AgitPOV/Pinky/circuit/pinky 2.2 (v-usb)/usnoobie_sch_pic-20110115.png

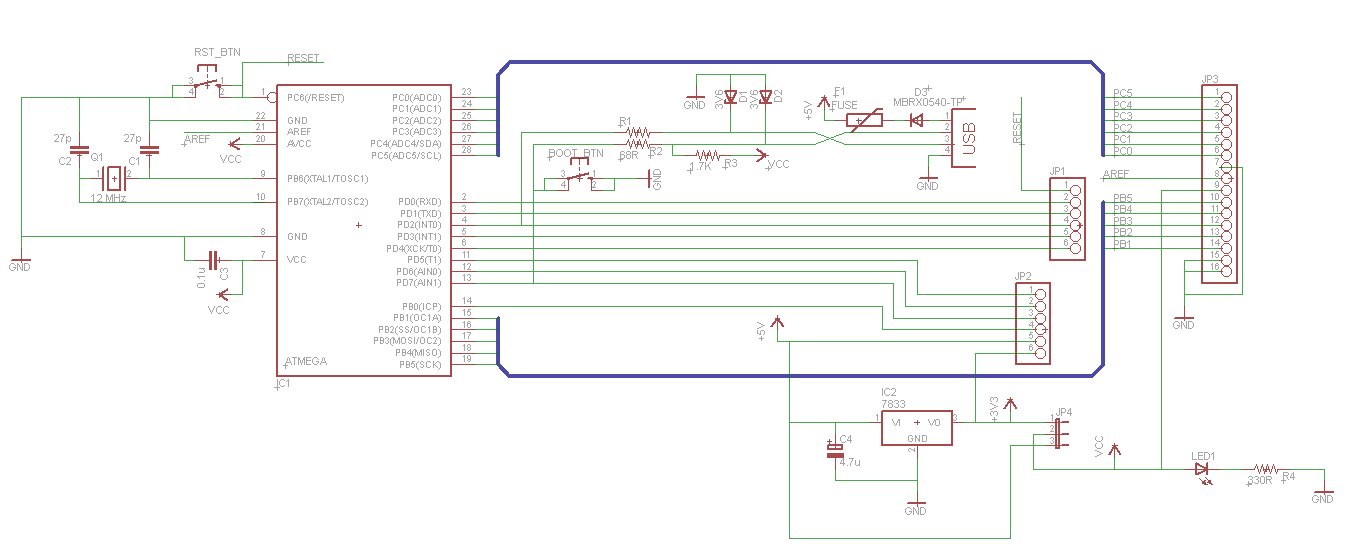
circuit/pinky 2.2 (v-usb)/usnoobie_sch_pic-20110115.png
