AgitPOV/Pinky/circuit/pinky 2.1/pinky 2.1.brd

## EAGLE design circuit/pinky 2.1/pinky 2.1.brd (2013-12-24)

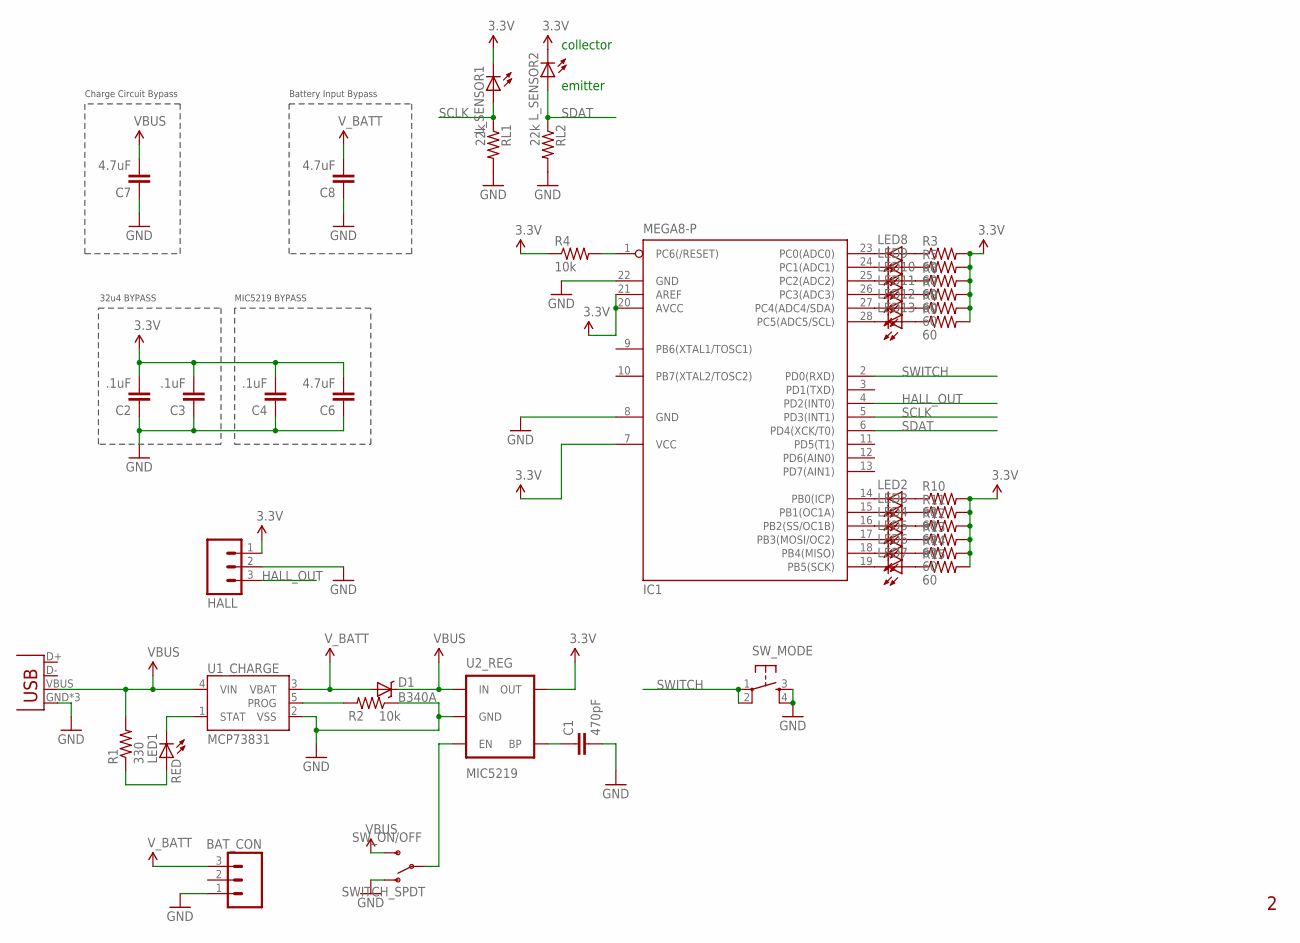
[picture p2: schematic pinky 2.1.sch]

Parts:
BAT_CON: M03PTH; 1X03
C1: 470pF; 1206
C2, C3, C4: .1uF; 1206
C6, C7, C8: 4.7uF; 1206
D1: B340A; SMA-DIODE
HALL: M03PTH; 1X03
IC1: MEGA8-P; DIL28-3
LED1: RED; LED-1206
LED2, LED3, LED4, LED5, LED6, LED7, LED8, LED9, LED10, LED11, LED12, LED13: LED1206; LED-1206
L_SENSOR1, L_SENSOR2: LED3MM
R1: 330; 1206
R2, R4: 10k; 1206
R3, R5, R6, R7, R8, R9, R10, R11, R12, R13, R14, R15: 60; 1206
RL1, RL2: 22k; 1206
SW_MODE: TAC_SWITCHPTH; TACTILE-PTH
SW_ON/OFF: SWITCH_SPDT; KPS-1290
U1_CHARGE: MCP73831; SOT23-5
U2_REG: MIC5219; SOT23-5
X1_USB_MICRO: USB-MICROB

Connections:
3.3V: C2.2, C3.2, C4.2, C6.2, HALL.1, IC1.7 (VCC), IC1.20 (AVCC), IC1.21 (AREF), L_SENSOR1.K (C), L_SENSOR2.K (C), R3.2, R4.1, R5.2, R6.2, R7.2, R8.2, R9.2, R10.2, R11.2, R12.2, R13.2, R14.2, R15.2, U2_REG.5 (OUT)
5V: C7.2, D1.C, R1.2, SW_ON/OFF.S, U1_CHARGE.4 (VIN), U2_REG.1 (IN), X1_USB_MICRO.VBUS
GND: BAT_CON.1, C1.2, C2.1, C3.1, C4.1, C6.1, C7.1, C8.1, HALL.2, IC1.8 (GND), IC1.22 (GND), R2.1, RL1.2, RL2.2, SW_MODE.3, SW_MODE.4, SW_ON/OFF.O, U1_CHARGE.2 (VSS), U2_REG.2 (GND), X1_USB_MICRO.GND, X1_USB_MICRO.MT1 (GND), X1_USB_MICRO.MT2 (GND)
HALL_OUT: HALL.3, IC1.4 (PD2(INT0))
unnamed: IC1.1 (PC6(/RESET)), R4.2
unnamed: SW_ON/OFF.P, U2_REG.3 (EN)
unnamed: LED1.A, R1.1
unnamed: LED1.C, U1_CHARGE.1 (STAT)
unnamed: IC1.14 (PB0(ICP)), LED2.C
unnamed: R2.2, U1_CHARGE.5 (PROG)
unnamed: IC1.15 (PB1(OC1A)), LED3.C
unnamed: C1.1, U2_REG.4 (BP)
unnamed: IC1.16 (PB2(SS/OC1B)), LED4.C
unnamed: IC1.17 (PB3(MOSI/OC2)), LED5.C
unnamed: IC1.18 (PB4(MISO)), LED6.C
unnamed: IC1.19 (PB5(SCK)), LED7.C
unnamed: IC1.23 (PC0(ADC0)), LED8.C
unnamed: IC1.24 (PC1(ADC1)), LED9.C
unnamed: IC1.25 (PC2(ADC2)), LED10.C
unnamed: IC1.26 (PC3(ADC3)), LED11.C
unnamed: IC1.27 (PC4(ADC4/SDA)), LED12.C
unnamed: IC1.28 (PC5(ADC5/SCL)), LED13.C
unnamed: LED8.A, R3.1
unnamed: LED9.A, R5.1
unnamed: LED10.A, R6.1
unnamed: LED11.A, R7.1
unnamed: LED12.A, R8.1
unnamed: LED13.A, R9.1
unnamed: LED2.A, R10.1
unnamed: LED3.A, R11.1
unnamed: LED4.A, R12.1
unnamed: LED5.A, R13.1
unnamed: LED6.A, R14.1
unnamed: LED7.A, R15.1
SCLK: IC1.5 (PD3(INT1)), L_SENSOR1.A, RL1.1
SDAT: IC1.6 (PD4(XCK/T0)), L_SENSOR2.A, RL2.1
SWITCH: IC1.2 (PD0(RXD)), SW_MODE.1, SW_MODE.2
V_BATT: BAT_CON.3, C8.2, D1.A, U1_CHARGE.3 (VBAT)

Notes on the sheet:
32u4 BYPASS
MIC5219 BYPASS
Charge Circuit Bypass
Battery Input Bypass
collector
emitter

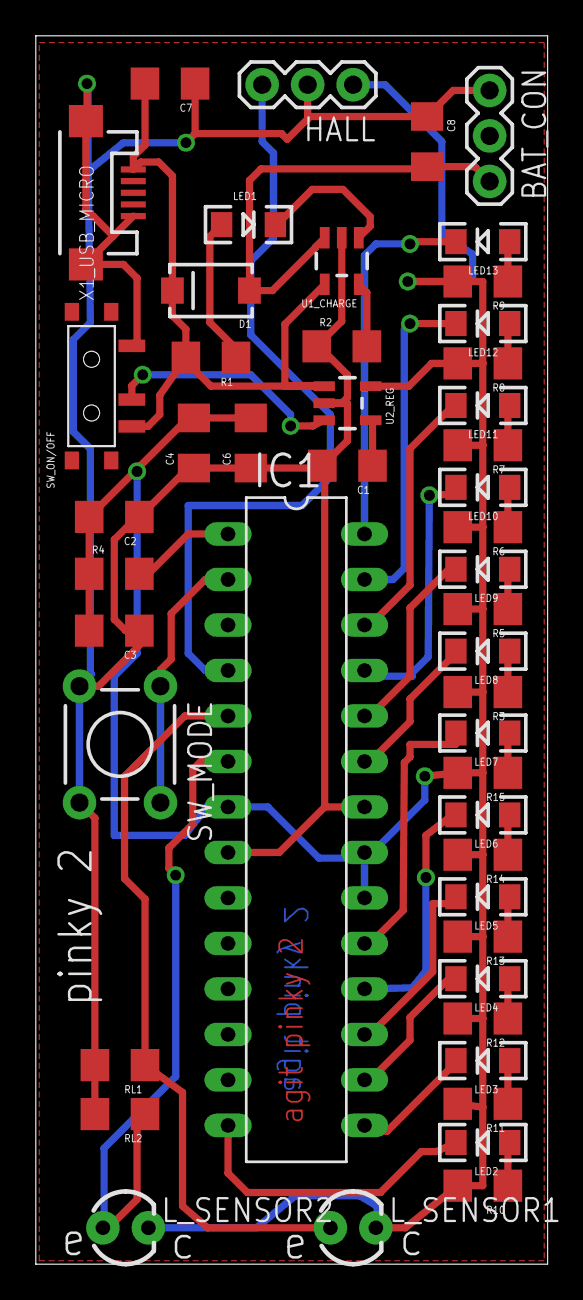
[picture p3: board pinky 2.1.brd from above]

Board: 2 copper layers, 28.6 x 68.6 mm, 48 parts (0 on the bottom side), 38 nets.
