AgitPOV/Pinky/(notices)

Notices in the files:
code/Pinky2_2013_09_06/pov.ino:
This program is free software: you can redistribute it and/or modify
it under the terms of the GNU General Public License as published by
the Free Software Foundation, either version 3 of the License, or
(at your option) any later version.
parts and their libraries:
SparkFun-PowerIC: Licensing: CC v3.0 Share-Alike You are welcome to use this library for commercial purposes.
SparkFun-Aesthetics: Released under the Creative Commons
SparkFun-Aesthetics: http://creativecommons.org/licenses/by-sa/3.0
